xavoidx/STM32GuitarPedal/Pics/PCB.png

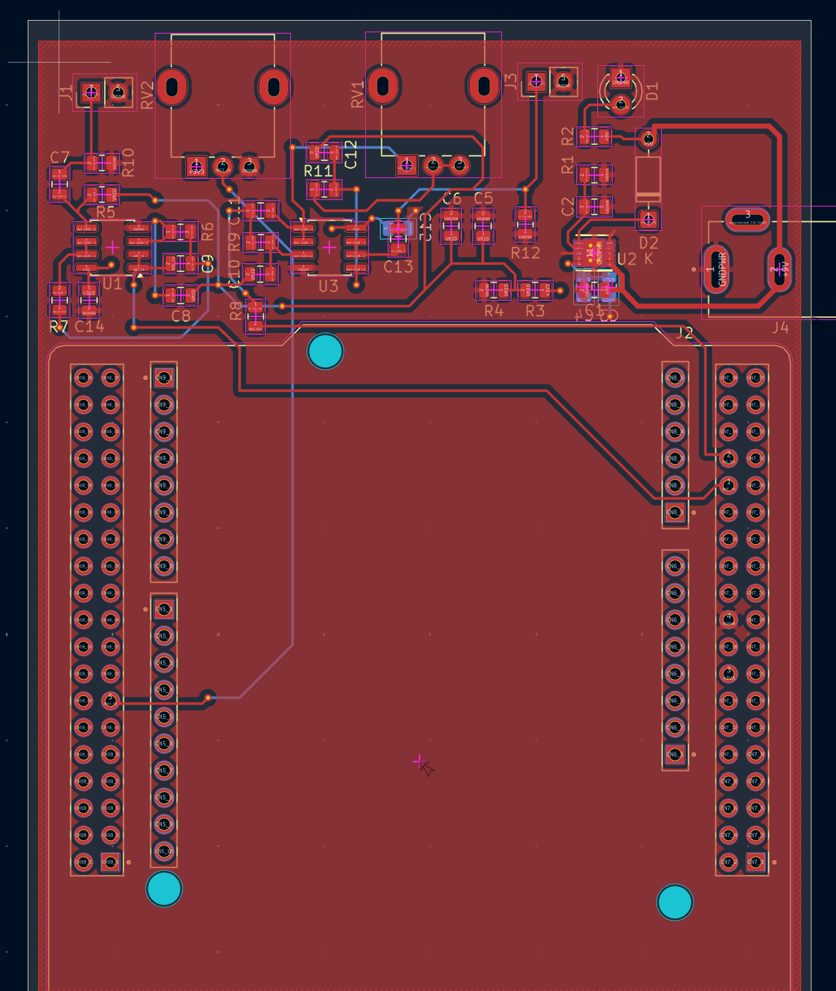
Pics/PCB.png
