xavoidx/STM32GuitarPedal/Core/Src/main.c

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
/* Includes ------------------------------------------------------------------*/
#include "main.h"
#include "adc.h"
#include "dac.h"
#include "dma.h"
#include "tim.h"
#include "gpio.h"

/* USER CODE BEGIN Includes */
#include <math.h>
#include <stdio.h>
#include <string.h>
#include "ola.h"
#include "arm_math.h"
#include "phase_vocoder.h"
/* USER CODE END Includes */

/* USER CODE BEGIN PTD */
#define FIR_NUM_TAPS 80
#define POLYPHASE_TAPS 20
#define UPSAMPLE_FACTOR 4
#define DOWNSAMPLE_FACTOR 4
#define WSOLA

typedef struct _Biquad
{
  float b0, b1, b2;
  float a1, a2;
  float x1, x2;
  float y1, y2;
} Biquad;
/* USER CODE END PTD */

/* USER CODE BEGIN PD */
#define BUFFER_SIZE 256
#define UPSAMPLE_BUFFER_SIZE (UPSAMPLE_FACTOR * BUFFER_SIZE)
// FIR_NUM_TAPS defined in the private typedef section; it is used by FIR struct

/* USER CODE END PD */


/* USER CODE BEGIN PV */
static float decim_state[FIR_NUM_TAPS + UPSAMPLE_BUFFER_SIZE - 1];
static float interp_state[FIR_NUM_TAPS / UPSAMPLE_FACTOR + BUFFER_SIZE - 1];

const float h_decimation_coeffs[FIR_NUM_TAPS] = {
    -0.00046170067f,
    -0.0006826209f,
    -0.00052289446f,
    9.0989922e-19f,
    0.00066670505f,
    0.0010935766f,
    0.00090502407f,
    -1.4736314e-18f,
    -0.001250687f,
    -0.0020762829f,
    -0.0017179494f,
    2.4273441e-18f,
    0.0023232347f,
    0.0037952333f,
    0.0030862971f,
    -3.6728746e-18f,
    -0.0040320467f,
    -0.0064817758f,
    -0.0051934653f,
    5.0820239e-18f,
    0.0066164049f,
    0.010529813f,
    0.0083678022f,
    -6.5097524e-18f,
    -0.010550481f,
    -0.016761257f,
    -0.013331607f,
    7.8091081e-18f,
    0.017002164f,
    0.02733178f,
    0.022115644f,
    -8.846352e-18f,
    -0.029864374f,
    -0.050256344f,
    -0.043358808f,
    9.5147237e-18f,
    0.0740235f,
    0.15820688f,
    0.22474334f,
    0.25f,
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
const float h_interpolation_coeffs[FIR_NUM_TAPS] = {
    -0.0018468027f, -0.0027304836f, -0.0020915779f, 3.6395969e-18f,
    0.0026668202f, 0.0043743064f, 0.0036200963f, -5.8945254e-18f,
    -0.0050027479f, -0.0083051317f, -0.0068717977f, 9.7093765e-18f,
    0.0092929389f, 0.015180933f, 0.012345189f, -1.4691498e-17f,
    -0.016128187f, -0.025927103f, -0.020773861f, 2.0328096e-17f,
    0.026465619f, 0.04211925f, 0.033471209f, -2.603901e-17f,
    -0.042201922f, -0.067045027f, -0.053326428f, 3.1236432e-17f,
    0.068008656f, 0.10932712f, 0.088462575f, -3.5385408e-17f,
    -0.1194575f, -0.20102538f, -0.17343523f, 3.8058895e-17f,
    0.296094f, 0.63282751f, 0.89897337f, 1.0f,
    0.89897337f, 0.63282751f, 0.296094f, 3.8058895e-17f,
    -0.17343523f, -0.20102538f, -0.1194575f, -3.5385408e-17f,
    0.088462575f, 0.10932712f, 0.068008656f, 3.1236432e-17f,
    -0.053326428f, -0.067045027f, -0.042201922f, -2.603901e-17f,
    0.033471209f, 0.04211925f, 0.026465619f, 2.0328096e-17f,
    -0.020773861f, -0.025927103f, -0.016128187f, -1.4691498e-17f,
    0.012345189f, 0.015180933f, 0.0092929389f, 9.7093765e-18f,
    -0.0068717977f, -0.0083051317f, -0.0050027479f, -5.8945254e-18f,
    0.0036200963f, 0.0043743064f, 0.0026668202f, 3.6395969e-18f,
    -0.0020915779f, -0.0027304836f, -0.0018468027f, 0.0f};
#ifdef WSOLA  
    OLA_State s;
#else
  Phase_Vocoder pv;
#endif
float processInputBuffer[BUFFER_SIZE] = {0.0f};
float processOutputBuffer[BUFFER_SIZE] = {0.0f};

static arm_fir_decimate_instance_f32 decim;
static arm_fir_interpolate_instance_f32 interp;

float oversampledInputBuffer[UPSAMPLE_BUFFER_SIZE] = {0.0f};
float oversampledOutputBuffer[UPSAMPLE_BUFFER_SIZE] = {0.0f};
volatile uint16_t adc_buffer[UPSAMPLE_BUFFER_SIZE * 2] = {0};
volatile uint16_t out_buffer[UPSAMPLE_BUFFER_SIZE * 2] = {0};
volatile uint16_t pot_params[1] = {0}; /* Dry/Wet potentiometer reading */
float dry_wet = 0.f;
/* USER CODE END PV */

void SystemClock_Config(void);
/* USER CODE BEGIN PFP */
void process_block();
/* USER CODE END PFP */

/**
  * @brief  The application entry point.
  * @retval int
  */
int main(void)
{

  /* MCU Configuration--------------------------------------------------------*/

  /* Reset of all peripherals, Initializes the Flash interface and the Systick. */
  HAL_Init();

  /* Configure the system clock */
  SystemClock_Config();

  /* Initialize all configured peripherals */
  MX_GPIO_Init();
  MX_DMA_Init();
  MX_DAC_Init();
  MX_ADC1_Init();
  MX_TIM2_Init();
  MX_ADC2_Init();
  MX_TIM3_Init();
  MX_TIM6_Init();
  /* USER CODE BEGIN 2 */
#ifdef WSOLA  
  OLA_Init(&s);
#else
  pv_init(&pv);
#endif
  if (arm_fir_decimate_init_f32(&decim, FIR_NUM_TAPS, DOWNSAMPLE_FACTOR,
                                h_decimation_coeffs, decim_state, UPSAMPLE_BUFFER_SIZE) != ARM_MATH_SUCCESS)
    Error_Handler();
  if (arm_fir_interpolate_init_f32(&interp, UPSAMPLE_FACTOR, FIR_NUM_TAPS,
                                   h_interpolation_coeffs, interp_state, BUFFER_SIZE) != ARM_MATH_SUCCESS)
    Error_Handler();

  HAL_ADC_Start_DMA(&hadc2, (uint32_t *)pot_params, 1);
  HAL_ADC_Start_DMA(&hadc1, (uint32_t *)adc_buffer, UPSAMPLE_BUFFER_SIZE * 2);
  HAL_DAC_Start_DMA(&hdac, DAC_CHANNEL_1,
                    (uint32_t *)out_buffer, UPSAMPLE_BUFFER_SIZE * 2, DAC_ALIGN_12B_R);

  HAL_TIM_Base_Start(&htim2); // ADC timer
  HAL_TIM_Base_Start(&htim3); // Potentiometer polling timer

  /* USER CODE END 2 */

  /* Infinite loop */
  /* USER CODE BEGIN WHILE */
  while (1)
  {
    /* USER CODE END WHILE */

    /* USER CODE BEGIN 3 */
  }
  /* USER CODE END 3 */
}

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
/* USER CODE BEGIN 4 */

void HAL_ADC_ConvHalfCpltCallback(ADC_HandleTypeDef *hadc)
{
  if (hadc == &hadc1)
  {
    process_block(&adc_buffer[0], &out_buffer[0]);
  }
}
void HAL_ADC_ConvCpltCallback(ADC_HandleTypeDef *hadc)
{
  if (hadc == &hadc1)
  {
    process_block(&adc_buffer[UPSAMPLE_BUFFER_SIZE], &out_buffer[UPSAMPLE_BUFFER_SIZE]);
  }
  else if (hadc == &hadc2)
  {
    dry_wet = *pot_params / 4095.0f;
  }
}

void process_block(uint16_t *input_buffer, uint16_t *output_buffer)
{

  HAL_GPIO_WritePin(GPIOA, GPIO_PIN_0, GPIO_PIN_SET);

  for (int i = 0; i < UPSAMPLE_BUFFER_SIZE; ++i)
  {
    oversampledInputBuffer[i] = (input_buffer[i] - 2048) / 2048.0f;
  }

  HAL_GPIO_WritePin(GPIOA, GPIO_PIN_2, GPIO_PIN_SET);
  arm_fir_decimate_f32(&decim, oversampledInputBuffer, processInputBuffer, UPSAMPLE_BUFFER_SIZE);
  HAL_GPIO_WritePin(GPIOA, GPIO_PIN_2, GPIO_PIN_RESET);
  #ifdef WSOLA
    OLA_Process(&s, processInputBuffer, processOutputBuffer, BUFFER_SIZE);
  #else
    //HAL_GPIO_WritePin(GPIOA, GPIO_PIN_0, GPIO_PIN_SET);
    pv_process(&pv, processInputBuffer, processOutputBuffer, BUFFER_SIZE);
    //HAL_GPIO_WritePin(GPIOA, GPIO_PIN_0, GPIO_PIN_RESET);
  #endif
  for(size_t i; i < BUFFER_SIZE; ++i) {
    processOutputBuffer[i] = dry_wet * processOutputBuffer[i] + (1 - dry_wet) * processInputBuffer[i];
  }
  
  /**
   * Upsample to 48kHz * UPSAMPLE_FACTOR,
   * using polyphase interpolation (79 + 1 zero-pad)-tap FIR filter.
   */
  arm_fir_interpolate_f32(&interp, processOutputBuffer, oversampledOutputBuffer, BUFFER_SIZE);

  /**
   * Scaling buffer back to DAC's 12 bit format, centered at 2048.
   * Values are cast to int32_t for more headroom, clamped, then
   * cast to uint16_t to avoid wraparound distortion
   */
  for (int i = 0; i < UPSAMPLE_BUFFER_SIZE; ++i)
  {
    int32_t out_clamped = (int32_t)(oversampledOutputBuffer[i] * 2048.0f + 2048.0f);
    if (out_clamped > 4095)
      out_clamped = 4095;
    if (out_clamped < 0)
      out_clamped = 0;
    output_buffer[i] = (uint16_t)out_clamped;
  }
  HAL_GPIO_WritePin(GPIOA, GPIO_PIN_0, GPIO_PIN_RESET);
}

/* USER CODE END 4 */
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
