xavoidx/STM32GuitarPedal/GuitarPedal.ioc

Mcu.UserName=STM32F446RETx
PA0-WKUP.GPIO_Label=Process Complete Indicator
PA0-WKUP.Signal=GPIO_Output
PA1.Signal=ADCx_IN1
PA4.Signal=COMP_DAC1_group
PA5.Signal=GPIO_Output
PA6.Signal=ADCx_IN6
PH0-OSC_IN.Signal=RCC_OSC_IN
PH1-OSC_OUT.Signal=RCC_OSC_OUT
