xavoidx/STM32GuitarPedal/(commit log)

2026-06-04 init: STM32 pedal firmware with ADC @ 48kHz, Simple biquad LP, Upsample to DAC @ 192kHz
2026-06-12 Set ADC to 192kHz, added decimation filter. DSP operates at 48kHz, I/O operates at 192kHz.
2026-06-17 Working OLA octave up. ADC & DAC both successfully running on same clock at 192kHz.
2026-06-20 Added cross-correlation scanning to OLA algorithm to make it a WSOLA algorithm. Callback time too long now.
    [main.c, ola.c, ola.h]
2026-08-11 Added basic implementation of a phase vocoder to compare its polyphonic performance against the WSOLA. Had claude make some optimizations to the WSOLA algorithm; currently hitting about 60% of callba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
2026-08-12 Switched to a phasor implementation of the phase vocoder algorithm to meet callback deadline. Need to implement transient detection to reset phase accumulator.
    [GuitarPedal.ioc, main.c, phase_vocoder.c, phase_vocoder.h]
2026-08-17 Finished implementation of transient triggered phase reset, need to test
    [phase_vocoder.c, phase_vocoder.h]
2026-08-27 docs: track demo audio, replace unsupported <audio> tags with links, fix typos
